cese-dci/dci2020b-damf618/Disp_Sec_V_1/Disp_Sec_V_1.png

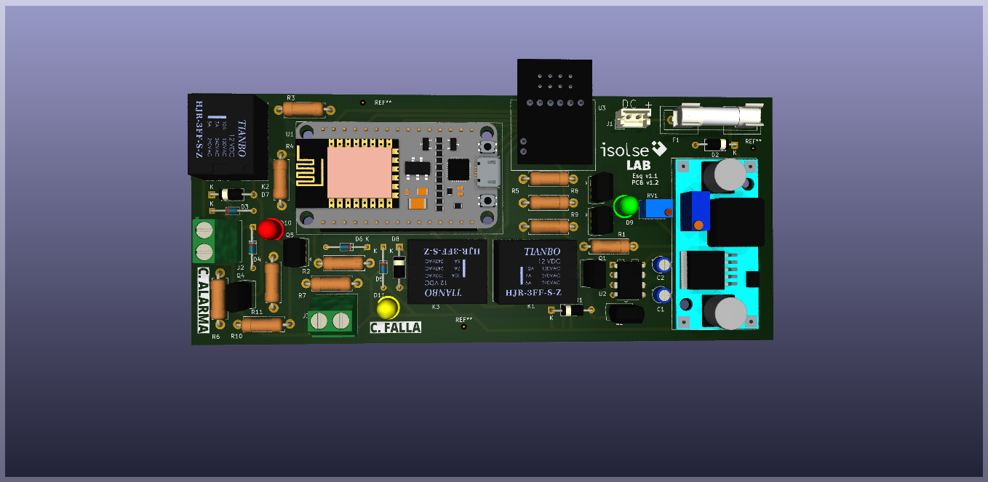
Disp_Sec_V_1/Disp_Sec_V_1.png
