cese-dci/dci2020b-damf618/Etapa_Inicial/IMG-20200628-WA0014(1).jpg

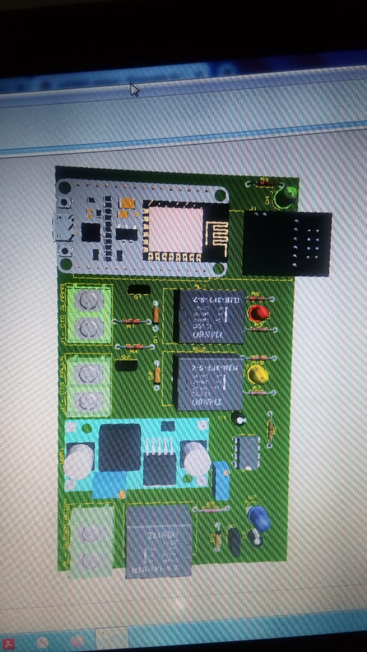
Etapa_Inicial/IMG-20200628-WA0014(1).jpg
