cese-dci/dci2020b-damf618/Etapa_Inicial/Prototipo2(1).PDF

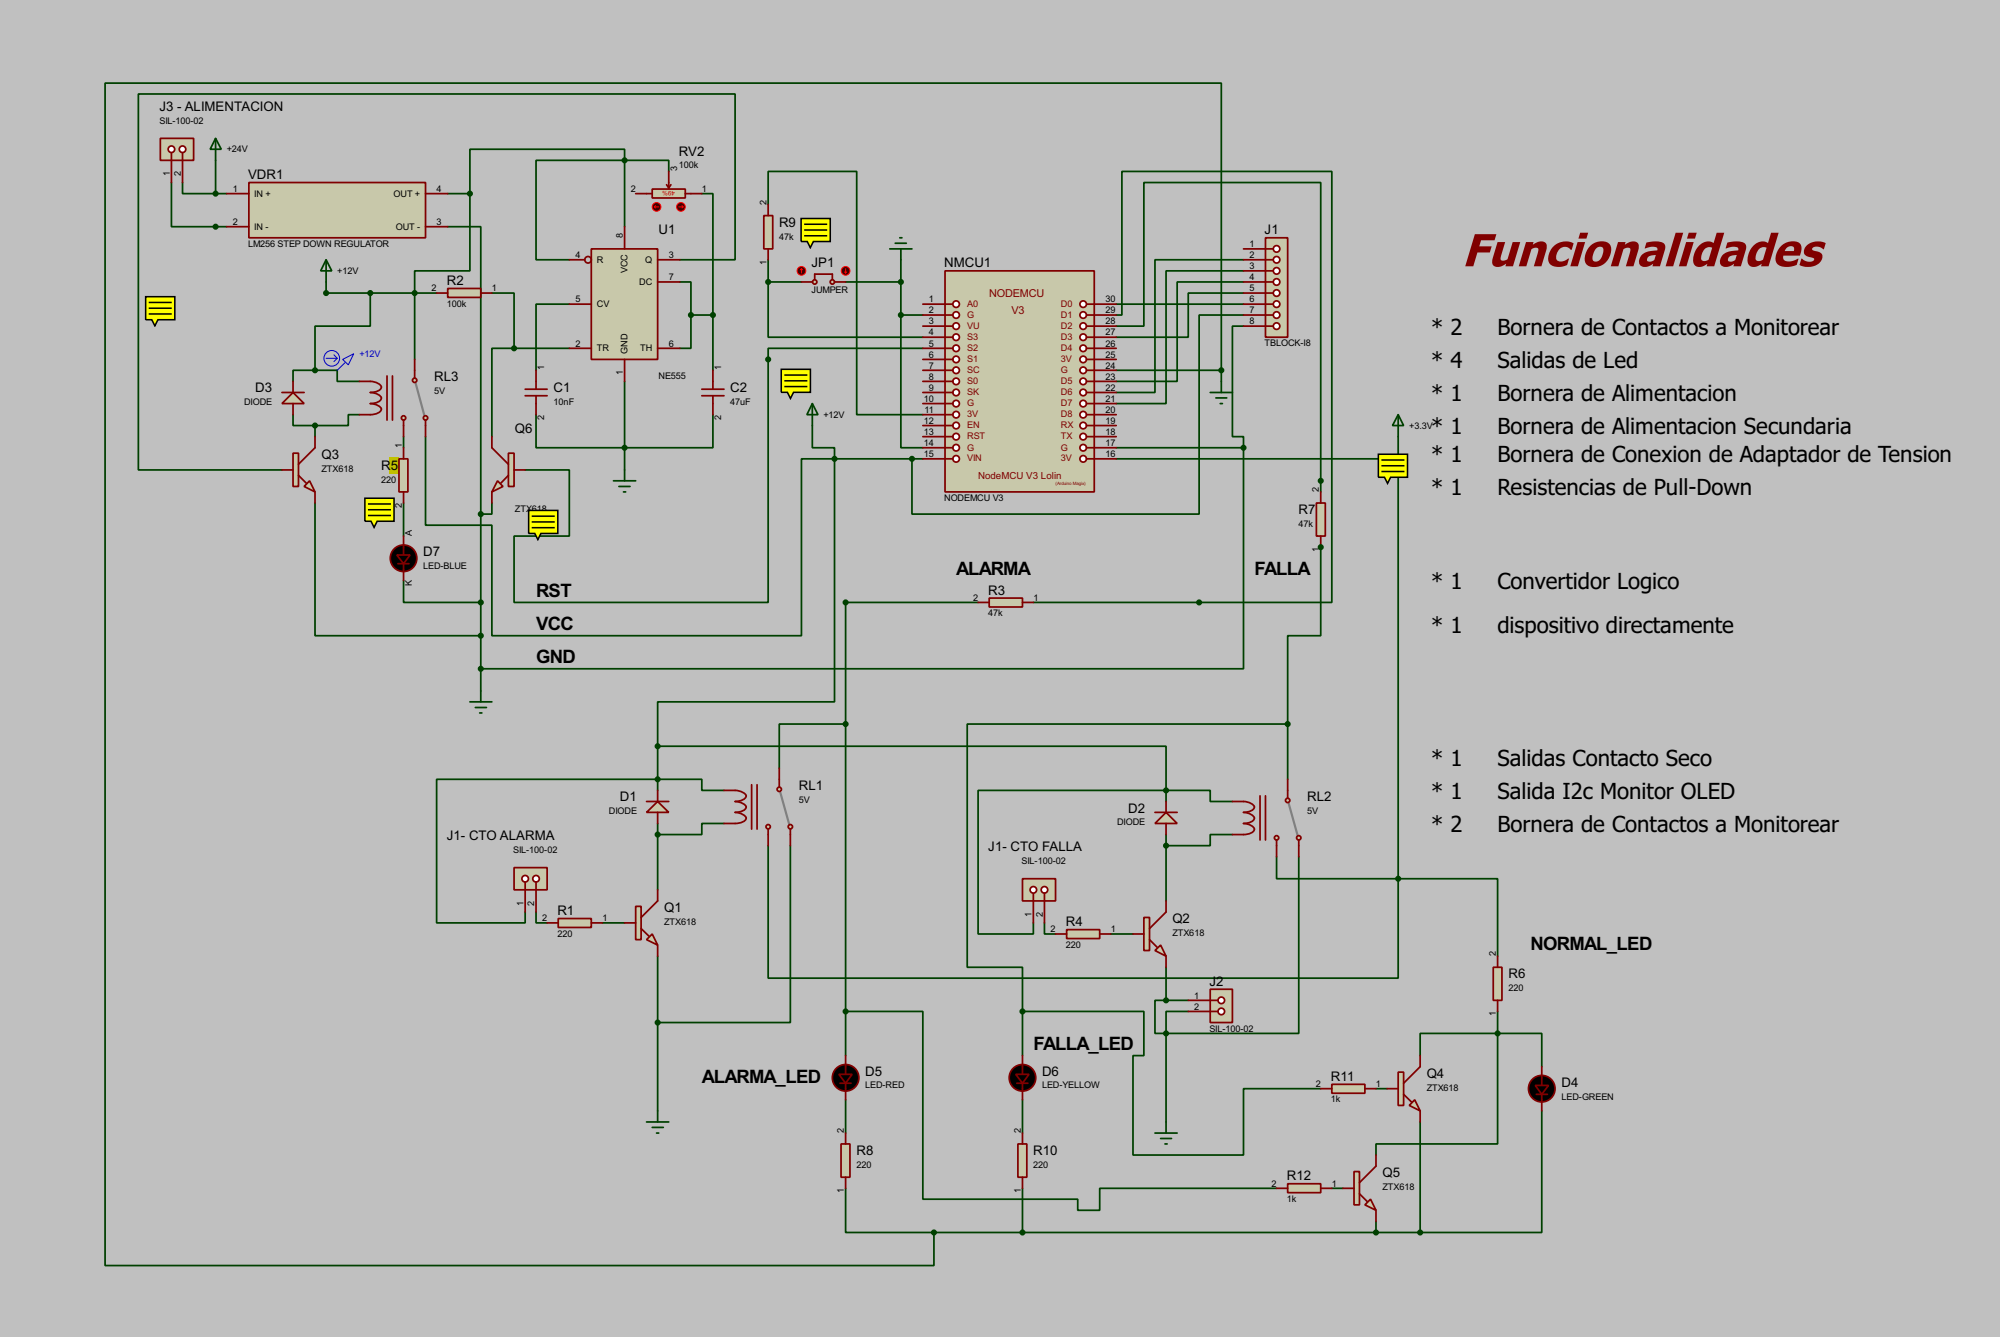
[picture p5: page 1]

D2 DIODE J1- CTO FALLA

SIL-100-02

Q2 ZTX618
