cese-dci/dci2020b-damf618/Disp_Sec_V_1/Disp_Sec_V_1-B_Cu.pdf

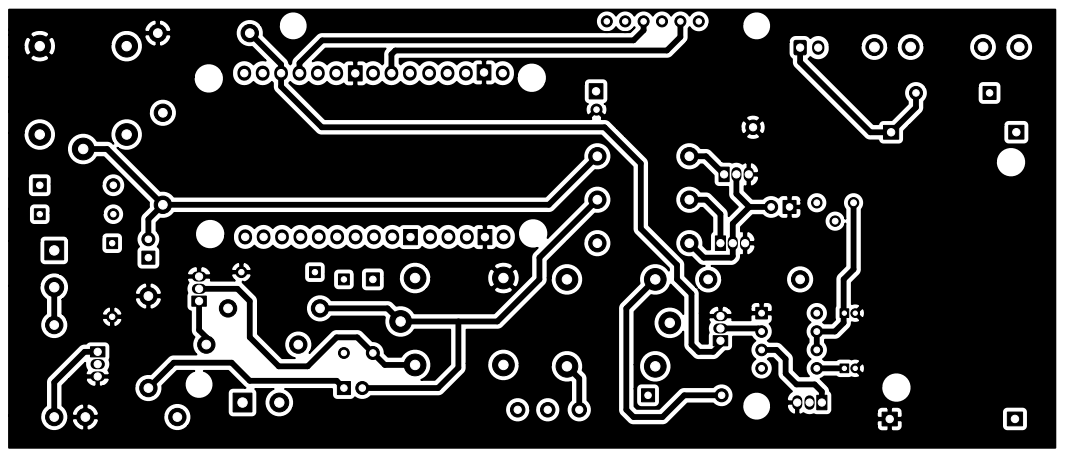
[picture p7: page 1]
