cese-dci/dci2020b-damf618/Disp_Sec_V_1/prod_pdf/Disp_Sec_V_1-B_Mask.pdf

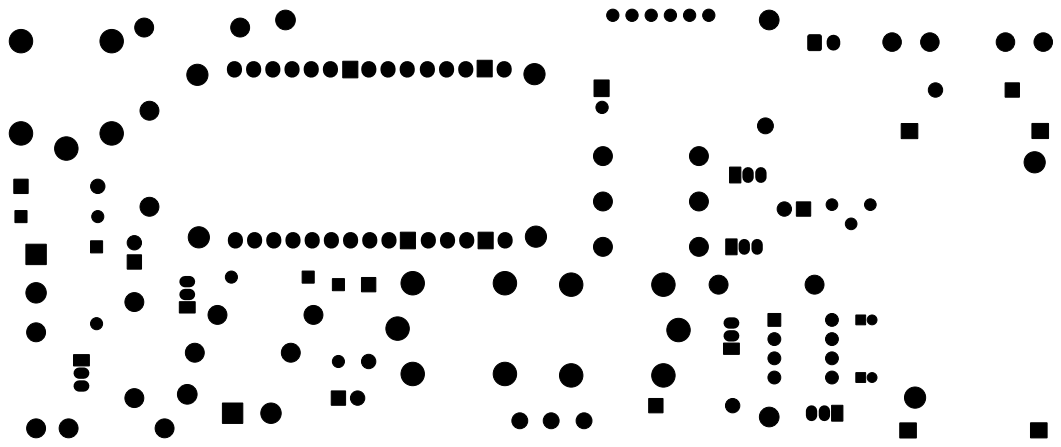
[picture p8: page 1]
