cese-dci/dci2020b-damf618/Disp_Sec_V_1/prod_pdf/Disp_Sec_V_1-F_CrtYd.pdf

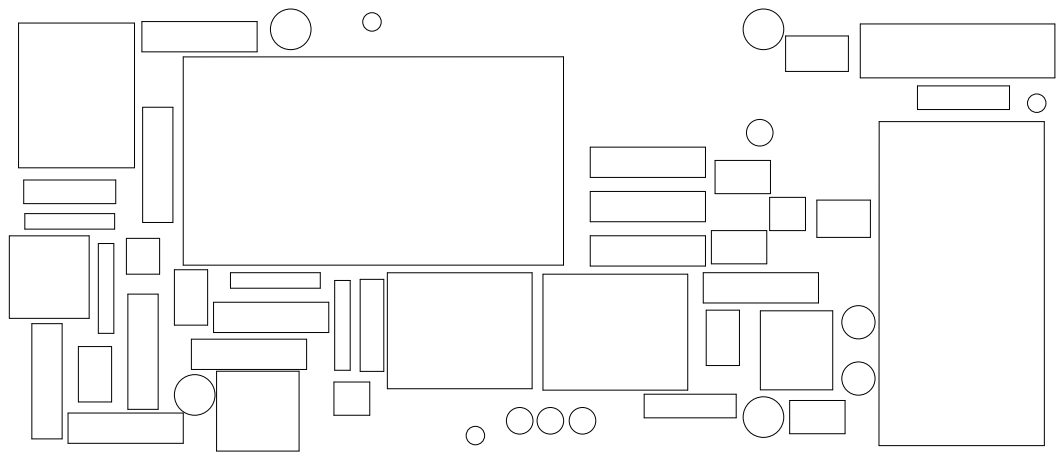
[picture p9: page 1]
