cese-dci/dci2020b-damf618/Disp_Sec_V_1/prod_pdf/Disp_Sec_V_1-F_Cu.pdf

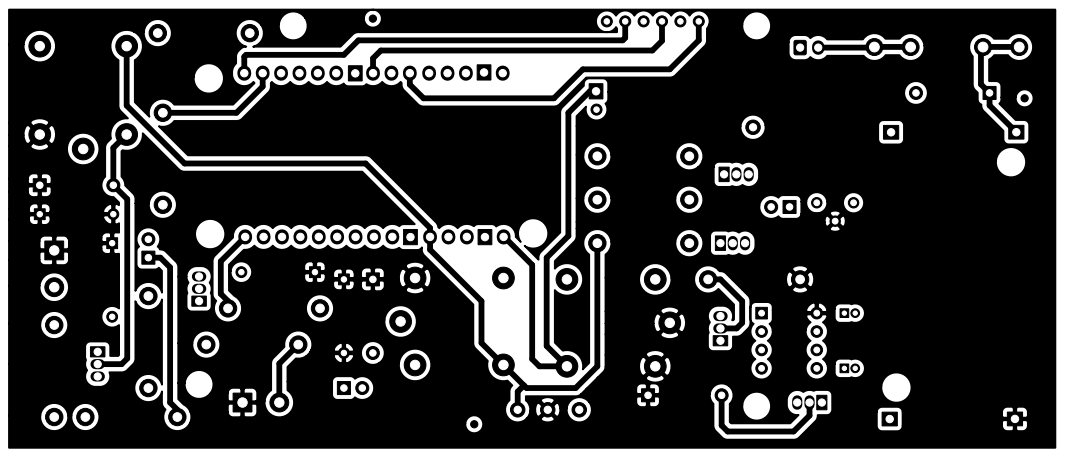
[picture p10: page 1]
