cese-dci/dci2020b-damf618/Disp_Sec_V_1/prod_pdf/Disp_Sec_V_1-F_Mask.pdf

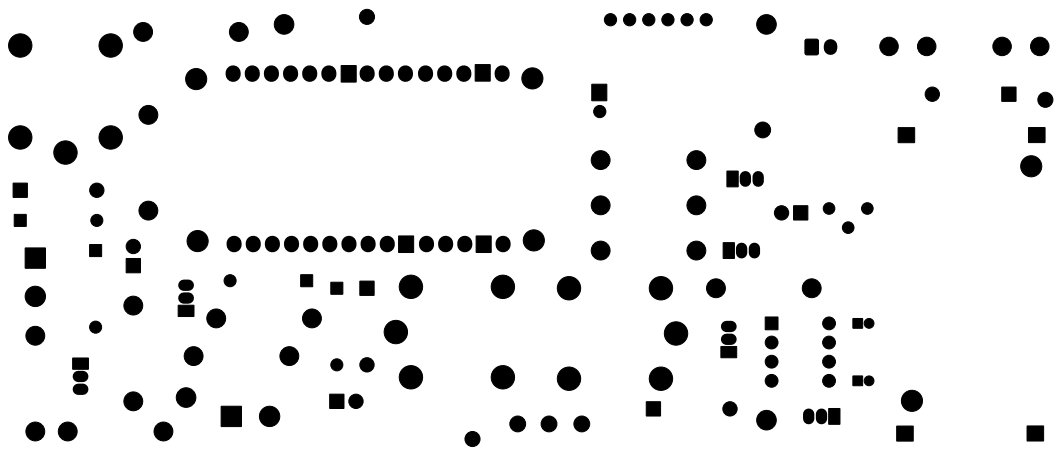
[picture p12: page 1]
