cese-dci/dci2020b-damf618/Disp_Sec_V_1/prod_pdf/Disp_Sec_V_1-F_SilkS.pdf

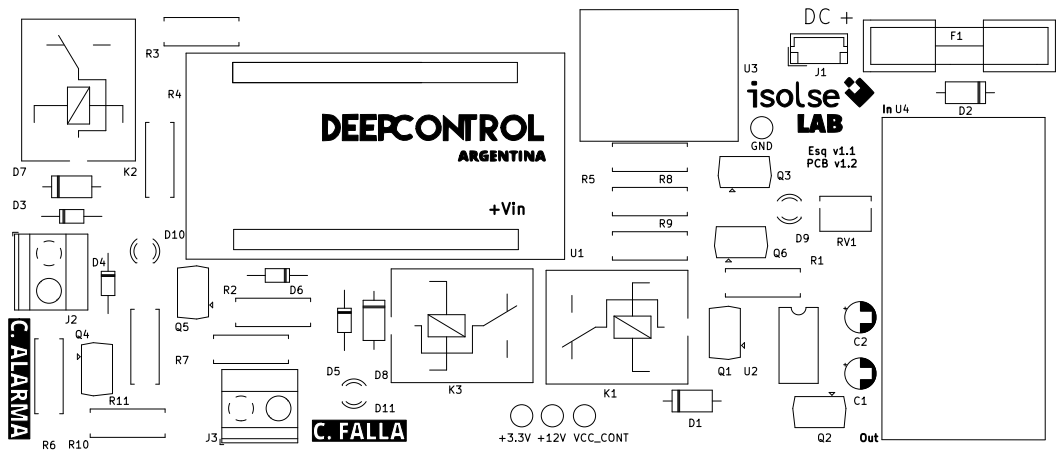
[picture p13: page 1]
