cese-dci/dci2020b-damf618/Disp_Sec_V_1/PROD_PDF_VIAS/Disp_Sec_V_1-B_Mask.pdf

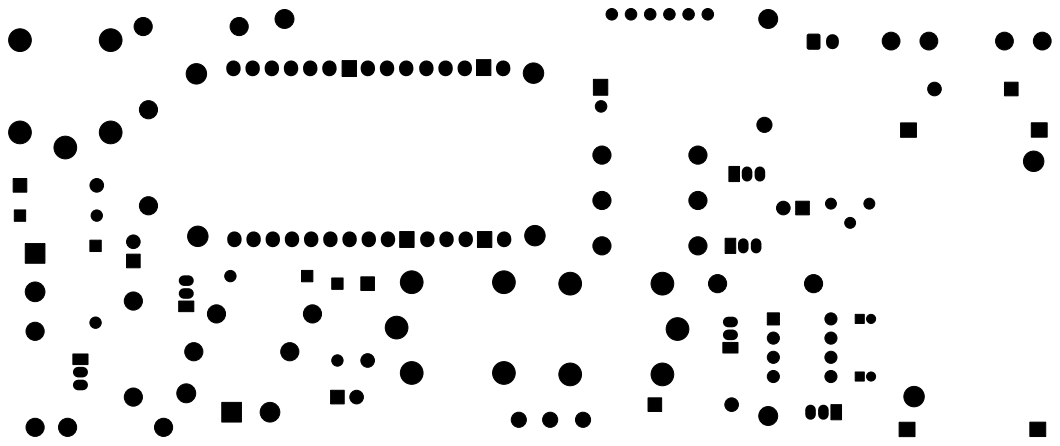
[picture p15: page 1]
