cese-dci/dci2020b-damf618/Disp_Sec_V_1/PROD_PDF_VIAS/Disp_Sec_V_1-F_Cu.pdf

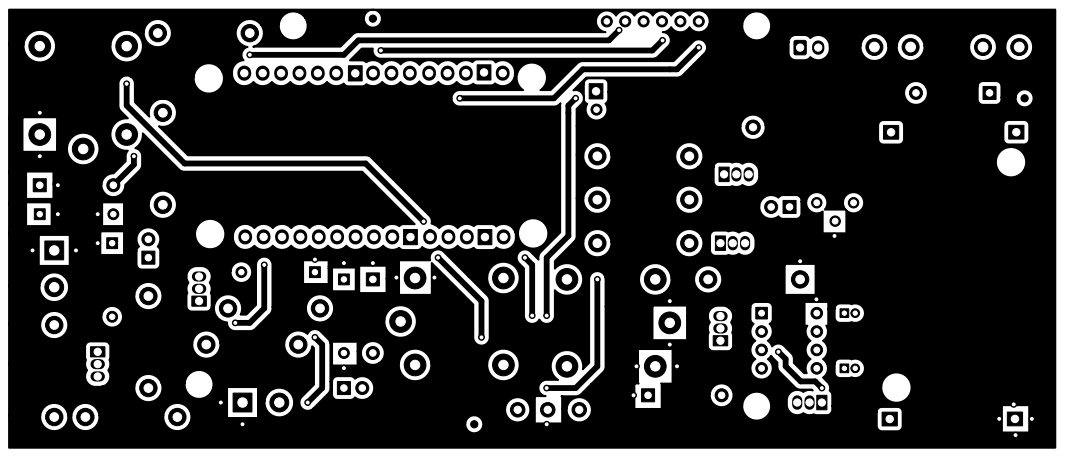
[picture p16: page 1]
