cese-dci/dci2020b-damf618/Disp_Sec_V_1/PROD_PDF_VIAS/Disp_Sec_V_1-F_Mask.pdf

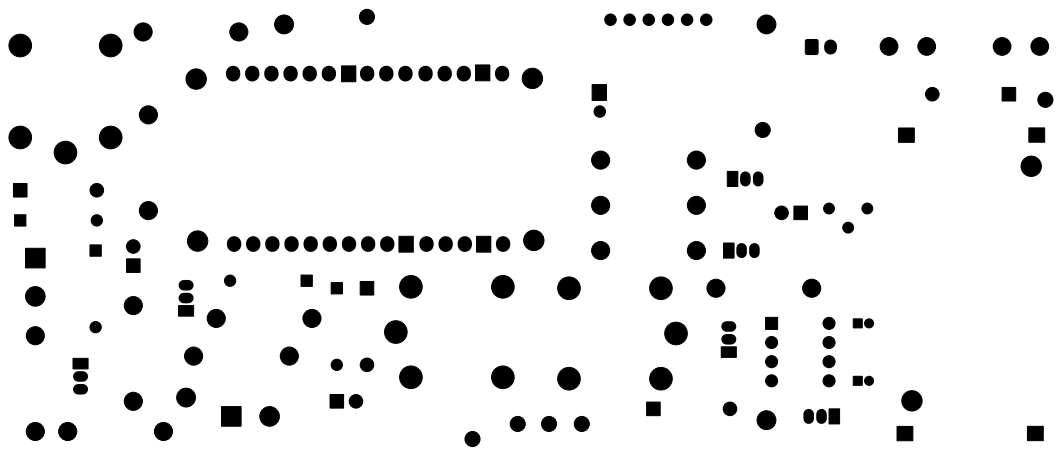
[picture p17: page 1]
