cese-dci/dci2020b-damf618/Disp_Sec_V_1/Disp_Sec_V_1.kicad_pcb

## KiCad design Disp_Sec_V_1/Disp_Sec_V_1.kicad_pcb (2020-10-27)

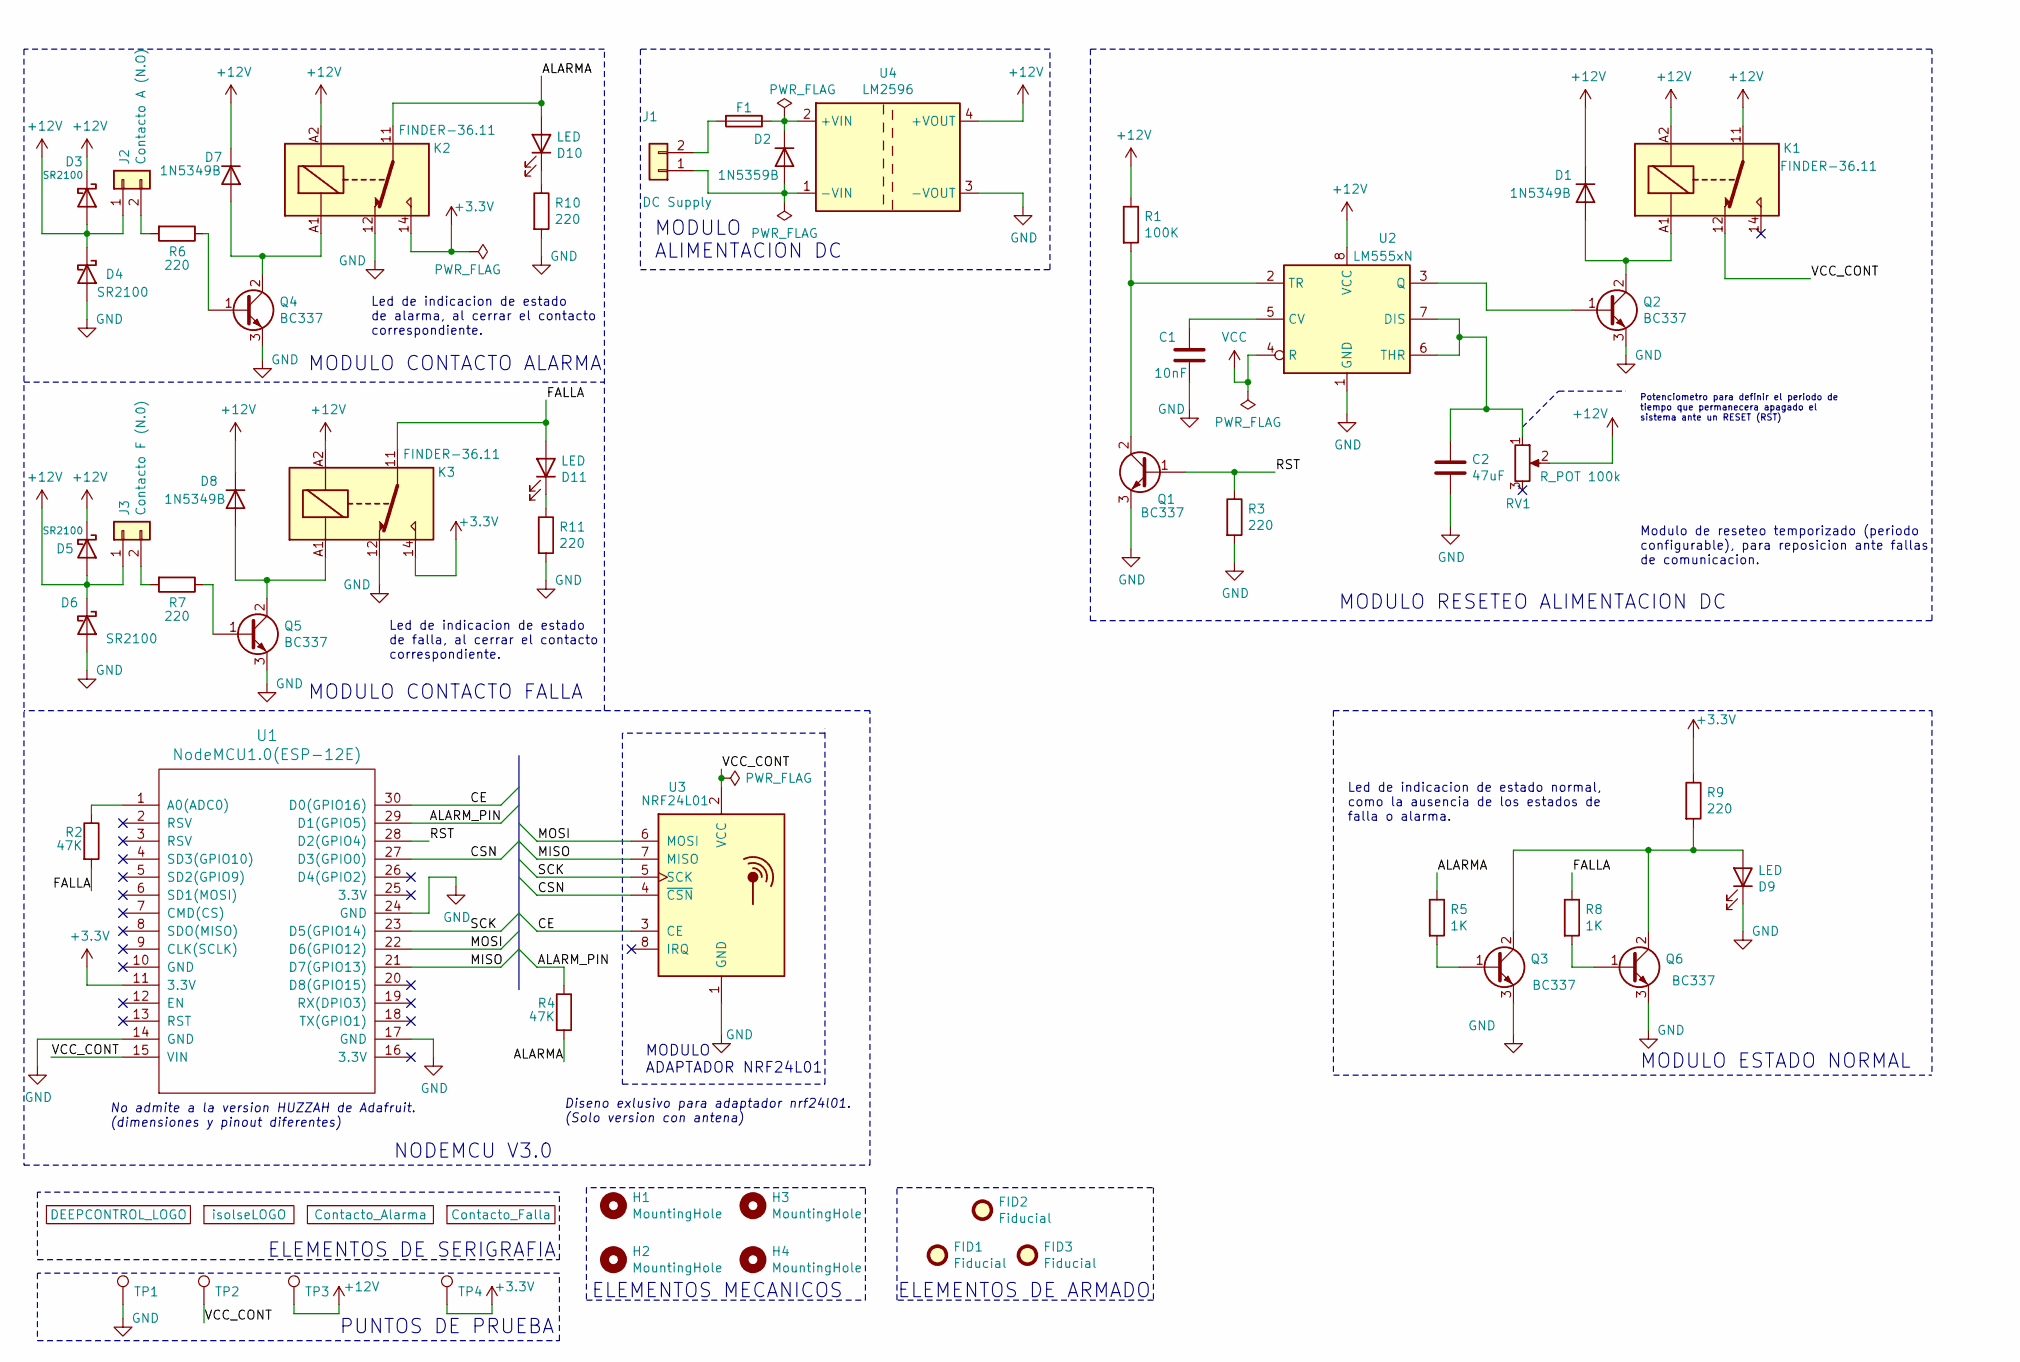
[picture p18: schematic Disp_Sec_V_1.sch, Dispositivo Secundario - SMRAI]

Parts:
C1: 10nF; CP_Radial_D4.0mm_P1.50mm
C2: 47uF; CP_Radial_D4.0mm_P1.50mm
D1, D7, D8: 1N5349B; D_A-405_P10.16mm_Horizontal
D2: 1N5359B; D_A-405_P10.16mm_Horizontal
D3, D4, D5, D6: SR2100; D_DO-34_SOD68_P10.16mm_Horizontal
D9, D10, D11: LED; LED_D3.0mm
F1: 100mA (5 x 20); Fuse
FID1, FID2, FID3: Fiducial; Fiducial_1mm_Mask2mm
H1, H2, H3, H4: MountingHole; MountingHole_2.5mm
J1: DC Supply; JST_EH_B2B-EH-A_1x02_P2.50mm_Vertical
J2: Contacto A (N.O); TerminalBlock_Phoenix_MKDS-1,5-2-5.08_1x02_P5.08mm_Horizont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
J3: Contacto F (N.0); TerminalBlock_Phoenix_MKDS-1,5-2-5.08_1x02_P5.08mm_Horizont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
K1, K2, K3: FINDER-36.11; Relay_SPDT_Finder_36.11
Q1, Q2, Q3, Q4, Q5, Q6: BC337; NEC_Molded_7x4x9mm
R1: 100K; R_Axial_DIN0411_L9.9mm_D3.6mm_P12.70mm_Horizontal
R2, R4: 47K; R_Axial_DIN0411_L9.9mm_D3.6mm_P12.70mm_Horizontal
R3, R6, R7, R9, R10, R11: 220; R_Axial_DIN0411_L9.9mm_D3.6mm_P12.70mm_Horizontal
R5, R8: 1K; R_Axial_DIN0411_L9.9mm_D3.6mm_P12.70mm_Horizontal
RV1: R_POT 100k; Potentiometer_Bourns_3266W_Vertical
TP1, TP2, TP3, TP4: TestPoint; TestPoint_Loop_D1.80mm_Drill1.0mm_Beaded
U1: NodeMCU1.0(ESP-12E); NodeMCU1.0
U2: LM555xN; DIP-8_W7.62mm
U3: NRF24L01; nRF24L01_Adapter
U4: LM2596; DC_DC_Converter_lm2596
U5: DEEPCONTROL_LOGO; DC
U6: isolseLOGO; isolse
U7: Contacto_Falla; C.FALLA
U8: Contacto_Alarma; C.ALARMA

Connections:
+3V3: K2.14, K3.14, R9.1, TP4.1, U1.11 (3.3V)
+12V: D1.1 (K), D3.1 (K), D3.2 (A), D4.1 (K), D5.1 (K), D5.2 (A), D6.1 (K), D7.1 (K), D8.1 (K), J2.1, J3.1, K1.11, K1.A2, K2.A2, K3.A2, R1.1, RV1.2, TP3.1, U2.8 (VCC), U4.4 (+VOUT)
/ALARMA: D10.2 (A), K2.11, R4.2, R5.1
/ALARM_PIN: R4.1, U1.29 (D1(GPIO5))
/CE: U1.30 (D0(GPIO16)), U3.3 (CE)
/CSN: U1.27 (D3(GPIO0)), U3.4 (~CSN)
/FALLA: D11.2 (A), K3.11, R2.2, R8.1
/MISO: U1.21 (D7(GPIO13)), U3.7 (MISO)
/MOSI: U1.22 (D6(GPIO12)), U3.6 (MOSI)
/RST: Q1.1 (B), R3.1, U1.28 (D2(GPIO4))
/SCK: U1.23 (D5(GPIO14)), U3.5 (SCK)
/VCC_CONT: K1.12, TP2.1, U1.15 (VIN), U3.2 (VCC)
GND: C1.2, C2.2, D4.2 (A), D6.2 (A), D9.1 (K), K2.12, K3.12, Q1.3 (E), Q2.3 (E), Q3.3 (E), Q4.3 (E), Q5.3 (E), Q6.3 (E), R3.2, R10.2, R11.2, TP1.1, U1.14 (GND), U1.17 (GND), U1.24 (GND), U2.1 (GND), U3.1 (GND), U4.3 (-VOUT)
unnamed: C1.1, U2.5 (CV)
unnamed: C2.1, RV1.1, U2.6 (THR), U2.7 (DIS)
unnamed: D1.2 (A), K1.A1, Q2.2 (C)
unnamed: D2.1 (K), F1.1, U4.2 (+VIN)
unnamed: D2.2 (A), J1.1, U4.1 (-VIN)
unnamed: D7.2 (A), K2.A1, Q4.2 (C)
unnamed: D8.2 (A), K3.A1, Q5.2 (C)
unnamed: D9.2 (A), Q3.2 (C), Q6.2 (C), R9.2
unnamed: D10.1 (K), R10.1
unnamed: D11.1 (K), R11.1
unnamed: F1.2, J1.2
unnamed: J2.2, R6.2
unnamed: J3.2, R7.2
unnamed: Q1.2 (C), R1.2, U2.2 (TR)
unnamed: Q2.1 (B), U2.3 (Q)
unnamed: Q3.1 (B), R5.2
unnamed: Q4.1 (B), R6.1
unnamed: Q5.1 (B), R7.1
unnamed: Q6.1 (B), R8.2
unnamed: R2.1, U1.1 (A0(ADC0))
VCC: U2.4 (R)

Notes on the sheet:
MODULO RESETEO ALIMENTACION DC
MODULO ADAPTADOR NRF24L01
MODULO ALIMENTACION DC
NODEMCU V3.0
Potenciometro para definir el periodo de tiempo que permanecera apagado el sistema ante un RESET (RST)
Diseno exlusivo para adaptador nrf24l01. (Solo version con antena)
No admite a la version HUZZAH de Adafruit. (dimensiones y pinout diferentes)
Modulo de reseteo temporizado (periodo configurable), para reposicion ante fallas de comunicacion.
ELEMENTOS MECANICOS
ELEMENTOS DE SERIGRAFIA
Led de indicacion de estado de alarma, al cerrar el contacto correspondiente.
Led de indicacion de estado de falla, al cerrar el contacto correspondiente.
MODULO CONTACTO ALARMA
MODULO CONTACTO FALLA
MODULO ESTADO NORMAL
Led de indicacion de estado normal, como la ausencia de los estados de falla o alarma.
ELEMENTOS DE ARMADO
PUNTOS DE PRUEBA

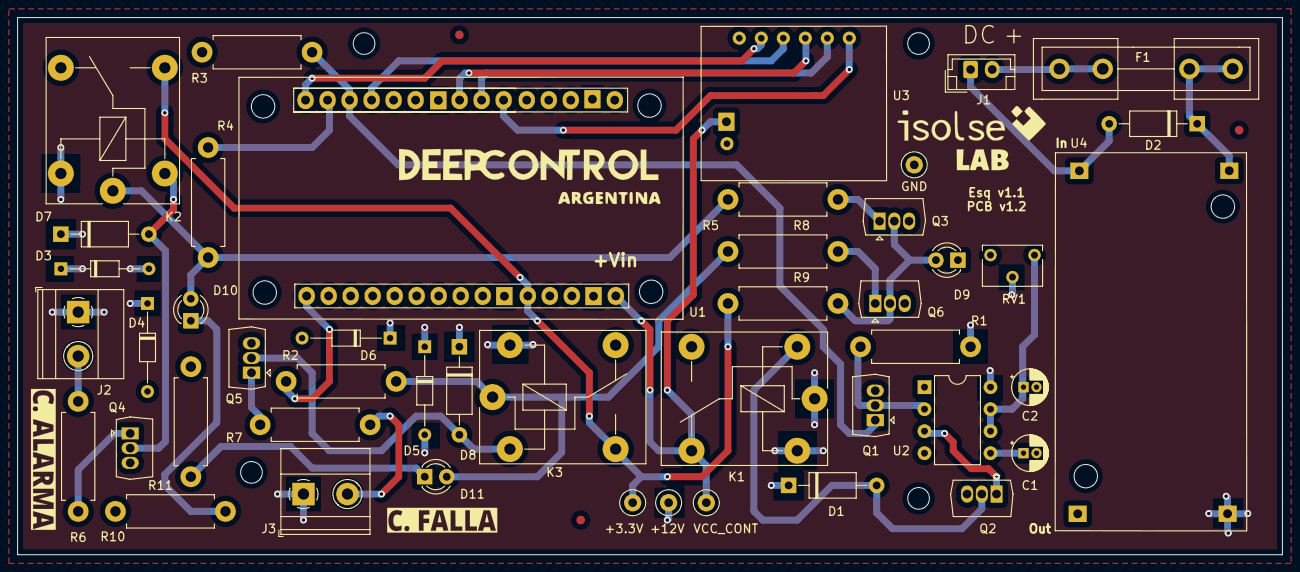
[picture p19: board Disp_Sec_V_1.kicad_pcb from above]

Board: 2 copper layers, 146.0 x 62.0 mm, 57 parts (0 on the bottom side), 33 nets.
