cese-dci/dci2020b-damf618/(commit log)

2020-09-26 Avances PCB
    [Disp_Sec_V_1.kicad_pcb, Disp_Sec_V_1.sch]
2020-09-26 Modificacion de NodeMCU Footprint
    [Disp_Sec_V_1.kicad_pcb]
2020-10-04 Disminuir Area,GND, VCC y nuevo logo
    [Disp_Sec_V_1.csv, Disp_Sec_V_1.kicad_pcb]
2020-10-14 Correcciones Finales
    [Disp_Sec_V_1.kicad_pcb, Disp_Sec_V_1.sch]
2020-10-23 Correcciones de Segunda Revision
    [Disp_Sec_V_1-B_Cu.gbr, Disp_Sec_V_1-B_Mask.gbr, Disp_Sec_V_1-Eco1_User.gbr, Disp_Sec_V_1-Edge_Cuts.gbr, Disp_Sec_V_1-F_CrtYd.gbr, Disp_Sec_V_1-F_Cu.gbr, Disp_Sec_V_1-F_Fab.gbr, Disp_Sec_V_1-F_Mask.gbr]
2020-10-25 Correcciones de Segunda Revision Fuse 3d
    [Disp_Sec_V_1.kicad_pcb]
2020-10-27 Correcion: Vias/Soldadura Back
    [Disp_Sec_V_1-B_Cu.gbr, Disp_Sec_V_1-B_Mask.gbr, Disp_Sec_V_1-Eco1_User.gbr, Disp_Sec_V_1-Edge_Cuts.gbr, Disp_Sec_V_1-F_CrtYd.gbr, Disp_Sec_V_1-F_Cu.gbr, Disp_Sec_V_1-F_Fab.gbr, Disp_Sec_V_1-F_Mask.gbr]
